cybertom24/6502-computer/README.md

# 6502-computer
My personal repo to build a breadboard version of a computer around the 6502 uProcessor. This project is inspired by the 6502 computer made by Ben Eater (https://eater.net/6502)
