cybertom24/6502-computer/board/out.png

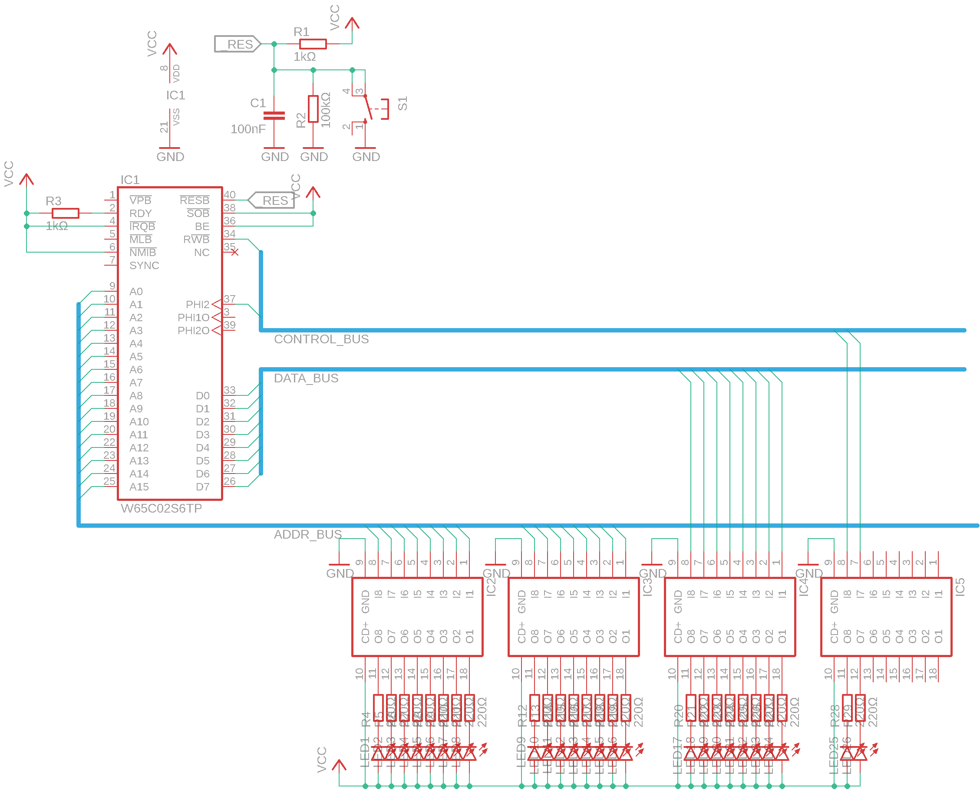
board/out.png
