cybertom24/6502-computer/board/beta-pcb.pdf

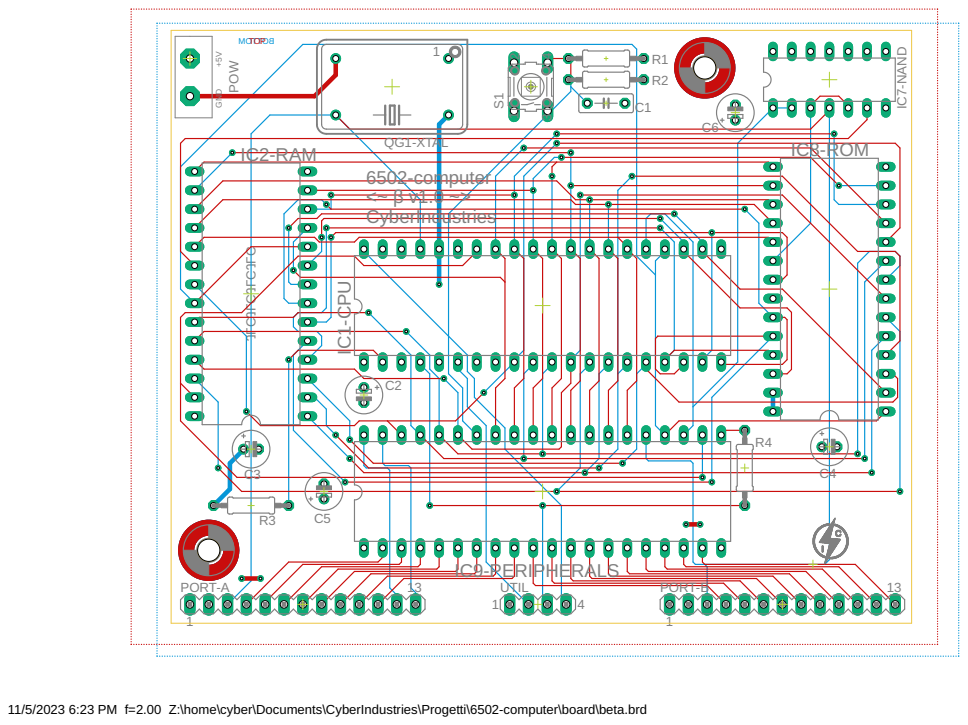
[picture p3: page 1]

11/5/2023 6:23 PM f=2.00 Z:\home\cyber\Documents\CyberIndustries\Progetti\6502-computer\board\beta.brd
