cybertom24/6502-computer/board/beta.pdf

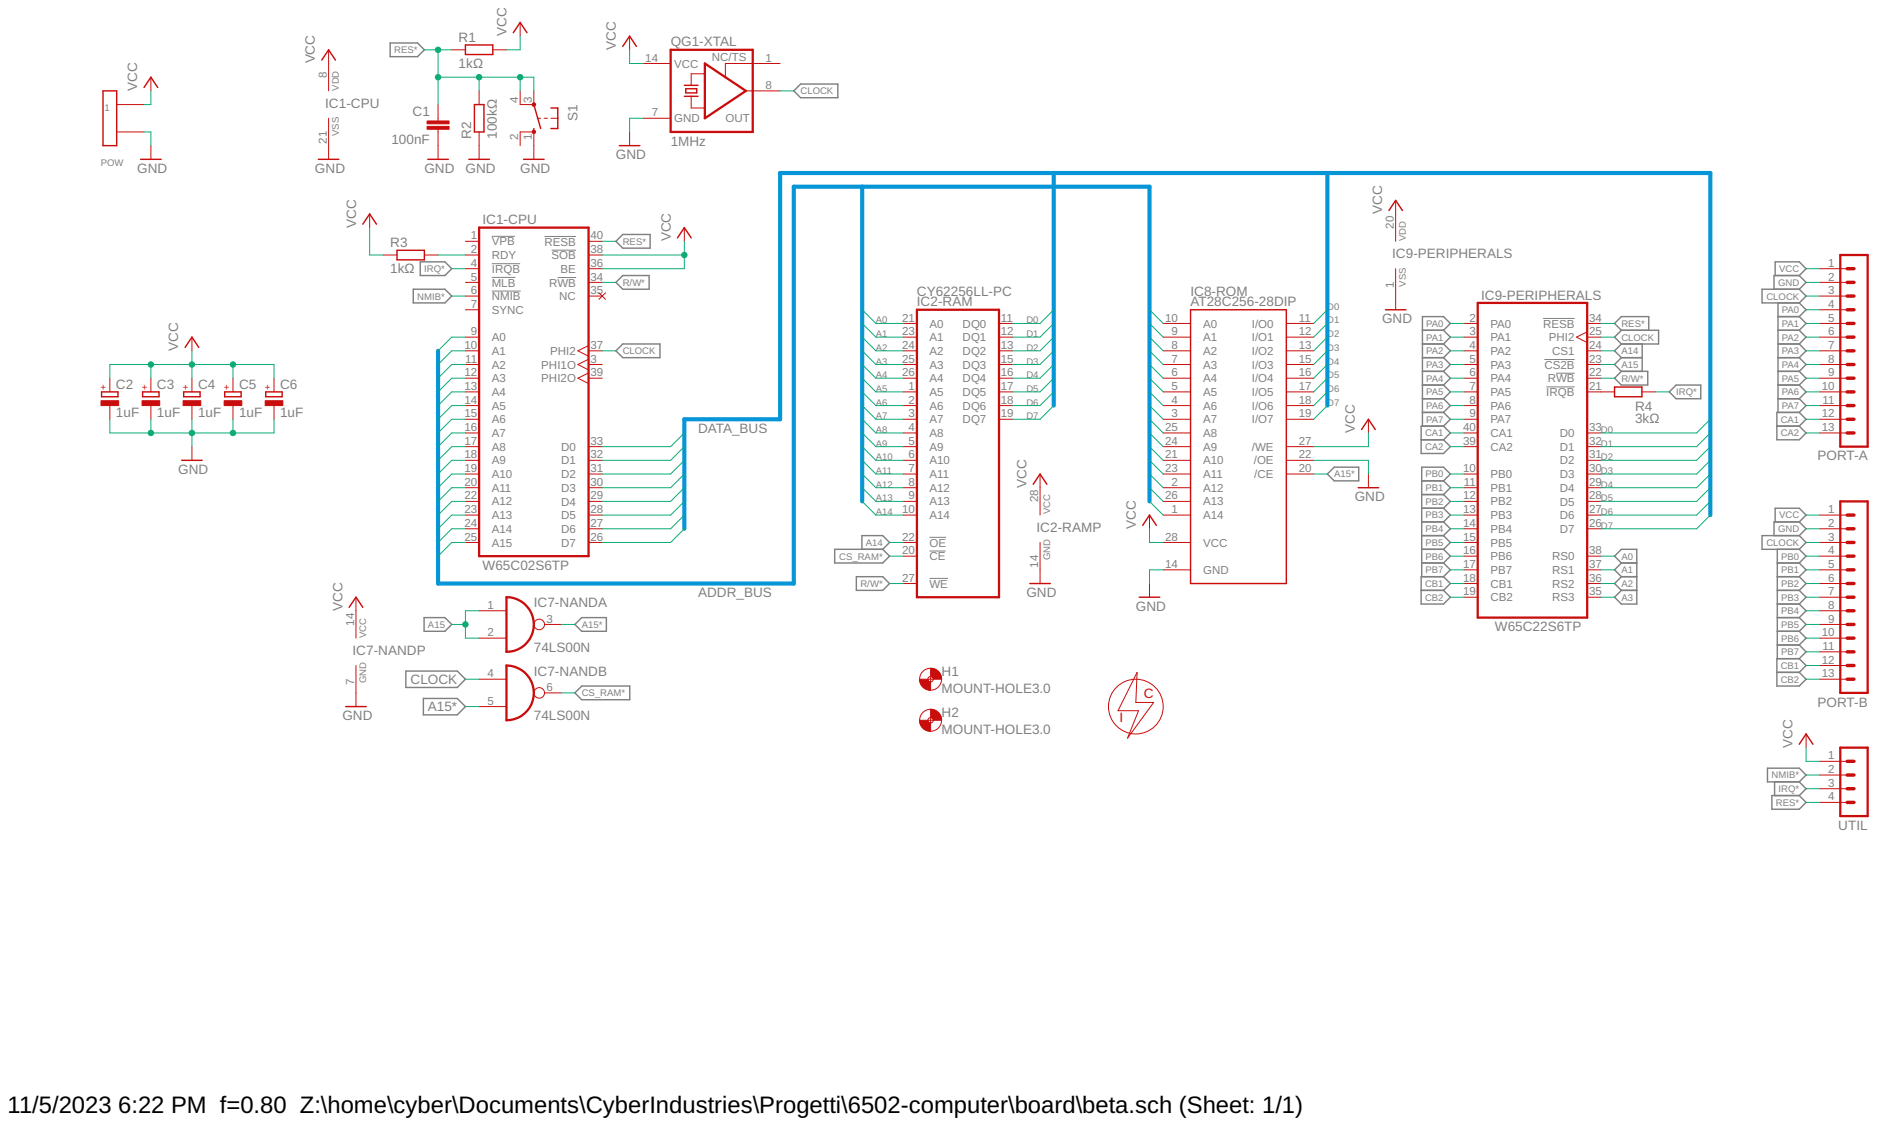
[picture p4: page 1]

11/5/2023 6:22 PM f=0.80 Z:\home\cyber\Documents\CyberIndustries\Progetti\6502-computer\board\beta.sch (Sheet: 1/1)
