cybertom24/6502-computer/board/gamma.brd

## EAGLE design board/gamma.brd (2024-02-10)

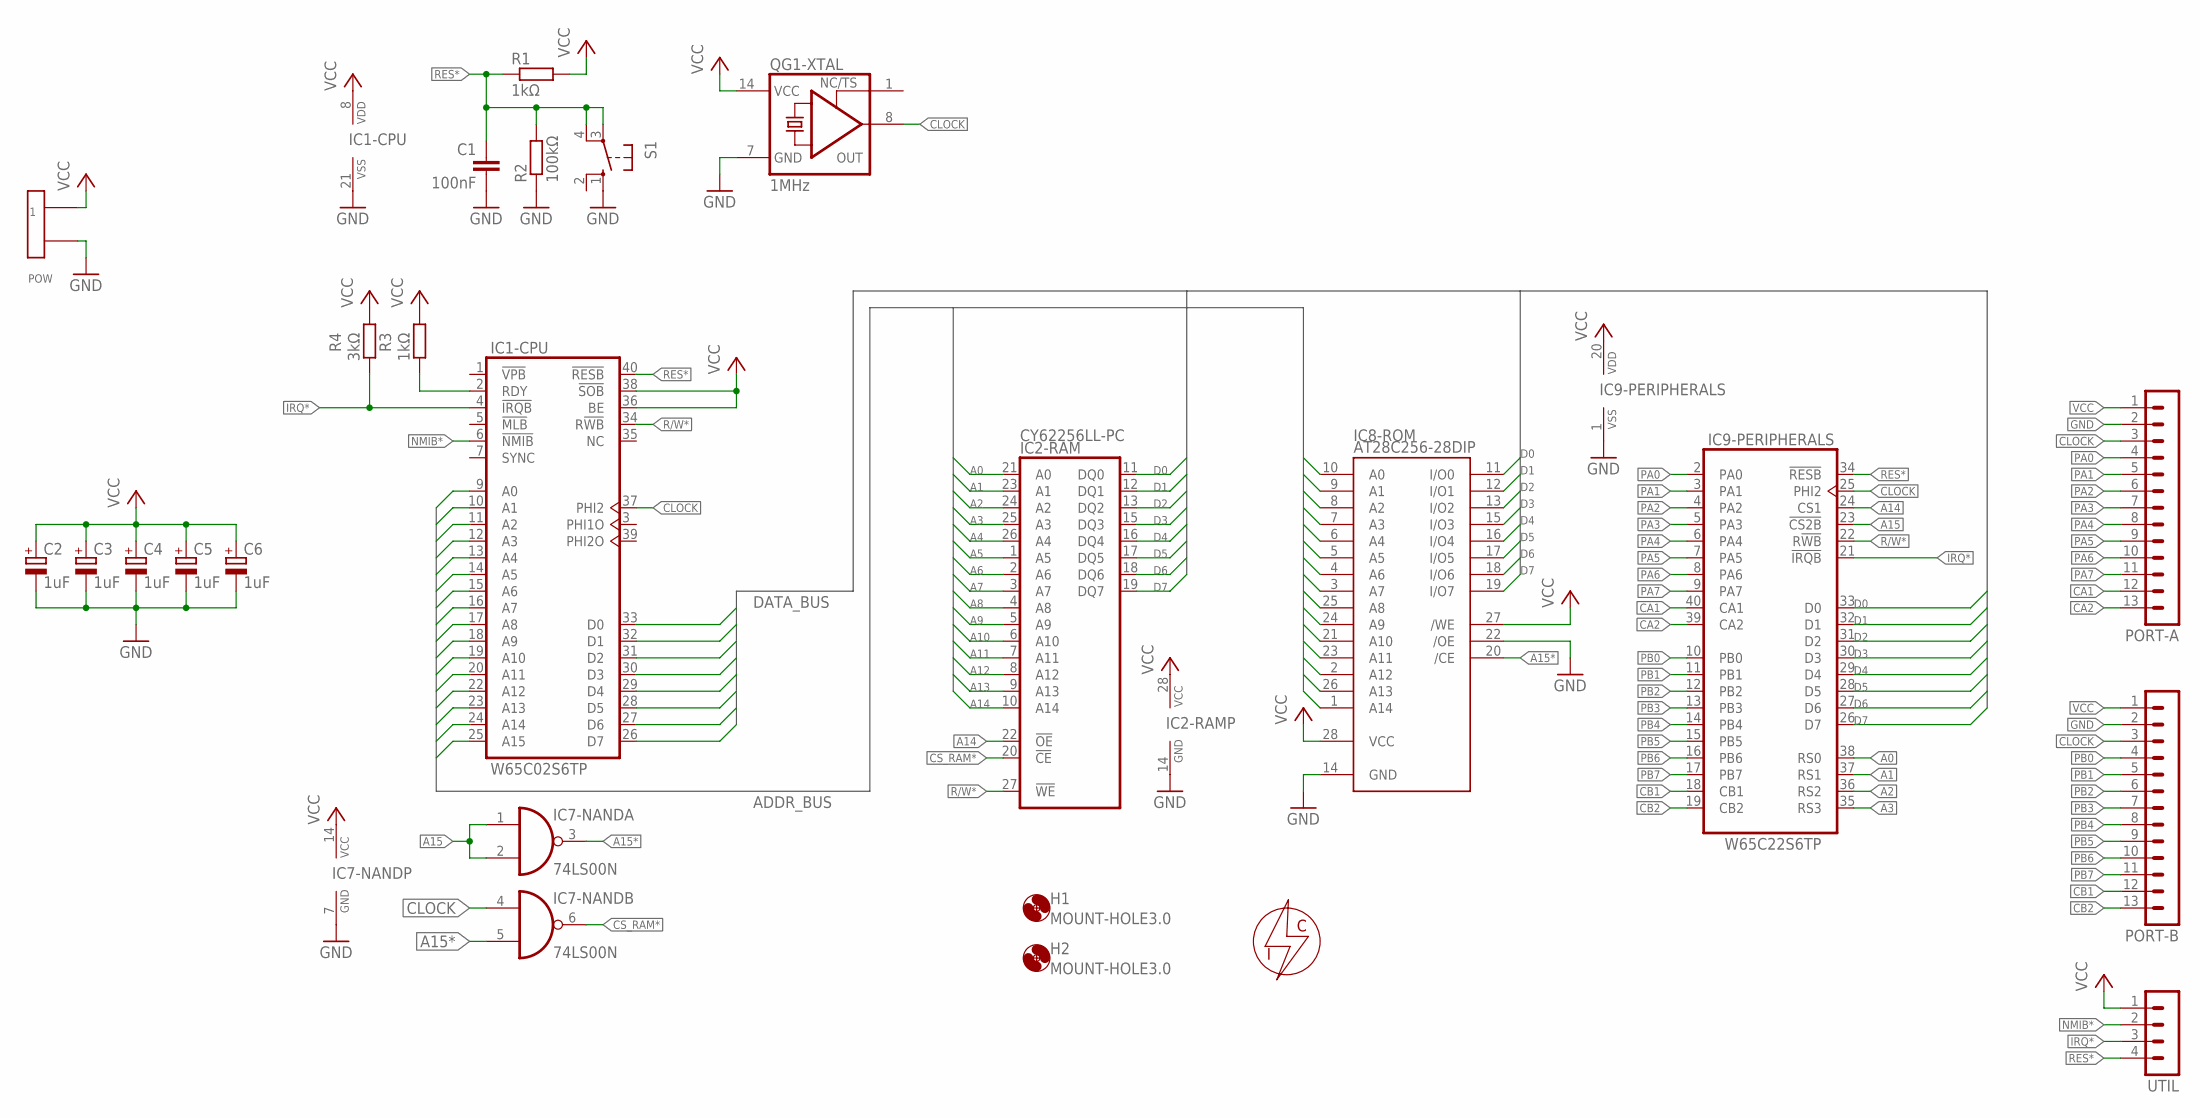
[picture p5: schematic gamma.sch]

Parts:
C1: 100nF; C050-025X075
C2, C3, C4, C5, C6: 1uF; E2-5
H1, H2: MOUNT-HOLE3.0; 3,0
IC1-CPU: W65C02S6TP; DIL40
IC2-RAM: CY62256LL-PC; DIL28-6
IC7-NAND: 74LS00N; DIL14
IC8-ROM: AT28C256-28DIP; DIL28-6
IC9-PERIPHERALS: W65C22S6TP; DIL40
PORT-A: MA13-1
PORT-B: MA13-1
POW: AK500; AK500-2
QG1-XTAL: 1MHz; DIL14S
R1, R3: 1kΩ; 0207/10
R2: 100kΩ; 0207/10
R4: 3kΩ; 0207/10
S1: 10-XX; B3F-10XX
U$1: LOGO-CYBERINDUSTRIES"; LOGO-SMALL
UTIL: MA04-1

Connections:
A0: IC1-CPU.9 (A0), IC2-RAM.21 (A0), IC8-ROM.10 (A0), IC9-PERIPHERALS.38 (RS0)
A1: IC1-CPU.10 (A1), IC2-RAM.23 (A1), IC8-ROM.9 (A1), IC9-PERIPHERALS.37 (RS1)
A2: IC1-CPU.11 (A2), IC2-RAM.24 (A2), IC8-ROM.8 (A2), IC9-PERIPHERALS.36 (RS2)
A3: IC1-CPU.12 (A3), IC2-RAM.25 (A3), IC8-ROM.7 (A3), IC9-PERIPHERALS.35 (RS3)
A4: IC1-CPU.13 (A4), IC2-RAM.26 (A4), IC8-ROM.6 (A4)
A5: IC1-CPU.14 (A5), IC2-RAM.1 (A5), IC8-ROM.5 (A5)
A6: IC1-CPU.15 (A6), IC2-RAM.2 (A6), IC8-ROM.4 (A6)
A7: IC1-CPU.16 (A7), IC2-RAM.3 (A7), IC8-ROM.3 (A7)
A8: IC1-CPU.17 (A8), IC2-RAM.4 (A8), IC8-ROM.25 (A8)
A9: IC1-CPU.18 (A9), IC2-RAM.5 (A9), IC8-ROM.24 (A9)
A10: IC1-CPU.19 (A10), IC2-RAM.6 (A10), IC8-ROM.21 (A10)
A11: IC1-CPU.20 (A11), IC2-RAM.7 (A11), IC8-ROM.23 (A11)
A12: IC1-CPU.22 (A12), IC2-RAM.8 (A12), IC8-ROM.2 (A12)
A13: IC1-CPU.23 (A13), IC2-RAM.9 (A13), IC8-ROM.26 (A13)
A14: IC1-CPU.24 (A14), IC2-RAM.10 (A14), IC2-RAM.22 (!OE), IC8-ROM.1 (A14), IC9-PERIPHERALS.24 (CS1)
A15: IC1-CPU.25 (A15), IC7-NAND.1 (I0), IC7-NAND.2 (I1), IC9-PERIPHERALS.23 (!CS2B)
A15*: IC7-NAND.3 (O), IC7-NAND.5 (I1), IC8-ROM.20 (/CE)
CA1: IC9-PERIPHERALS.40 (CA1), PORT-A.12
CA2: IC9-PERIPHERALS.39 (CA2), PORT-A.13
CB1: IC9-PERIPHERALS.18 (CB1), PORT-B.12
CB2: IC9-PERIPHERALS.19 (CB2), PORT-B.13
CLOCK: IC1-CPU.37 (PHI2), IC7-NAND.4 (I0), IC9-PERIPHERALS.25 (PHI2), PORT-A.3, PORT-B.3, QG1-XTAL.8 (OUT)
CS_RAM*: IC2-RAM.20 (!CE), IC7-NAND.6 (O)
D0: IC1-CPU.33 (D0), IC2-RAM.11 (DQ0), IC8-ROM.11 (I/O0), IC9-PERIPHERALS.33 (D0)
D1: IC1-CPU.32 (D1), IC2-RAM.12 (DQ1), IC8-ROM.12 (I/O1), IC9-PERIPHERALS.32 (D1)
D2: IC1-CPU.31 (D2), IC2-RAM.13 (DQ2), IC8-ROM.13 (I/O2), IC9-PERIPHERALS.31 (D2)
D3: IC1-CPU.30 (D3), IC2-RAM.15 (DQ3), IC8-ROM.15 (I/O3), IC9-PERIPHERALS.30 (D3)
D4: IC1-CPU.29 (D4), IC2-RAM.16 (DQ4), IC8-ROM.16 (I/O4), IC9-PERIPHERALS.29 (D4)
D5: IC1-CPU.28 (D5), IC2-RAM.17 (DQ5), IC8-ROM.17 (I/O5), IC9-PERIPHERALS.28 (D5)
D6: IC1-CPU.27 (D6), IC2-RAM.18 (DQ6), IC8-ROM.18 (I/O6), IC9-PERIPHERALS.27 (D6)
D7: IC1-CPU.26 (D7), IC2-RAM.19 (DQ7), IC8-ROM.19 (I/O7), IC9-PERIPHERALS.26 (D7)
GND: C1.2, C2.-, C3.-, C4.-, C5.-, C6.-, IC1-CPU.21 (VSS), IC2-RAM.14 (GND), IC7-NAND.7 (GND), IC8-ROM.14 (GND), IC8-ROM.22 (/OE), IC9-PERIPHERALS.1 (VSS), PORT-A.2, PORT-B.2, POW.P$2, QG1-XTAL.7 (GND), R2.1, S1.1 (S)
IRQ*: IC1-CPU.4 (!IRQB), IC9-PERIPHERALS.21 (!IRQB), R4.2, UTIL.3
unnamed: IC1-CPU.2 (RDY), R3.2
NMIB*: IC1-CPU.6 (!NMIB), UTIL.2
PA0: IC9-PERIPHERALS.2 (PA0), PORT-A.4
PA1: IC9-PERIPHERALS.3 (PA1), PORT-A.5
PA2: IC9-PERIPHERALS.4 (PA2), PORT-A.6
PA3: IC9-PERIPHERALS.5 (PA3), PORT-A.7
PA4: IC9-PERIPHERALS.6 (PA4), PORT-A.8
PA5: IC9-PERIPHERALS.7 (PA5), PORT-A.9
PA6: IC9-PERIPHERALS.8 (PA6), PORT-A.10
PA7: IC9-PERIPHERALS.9 (PA7), PORT-A.11
PB0: IC9-PERIPHERALS.10 (PB0), PORT-B.4
PB1: IC9-PERIPHERALS.11 (PB1), PORT-B.5
PB2: IC9-PERIPHERALS.12 (PB2), PORT-B.6
PB3: IC9-PERIPHERALS.13 (PB3), PORT-B.7
PB4: IC9-PERIPHERALS.14 (PB4), PORT-B.8
PB5: IC9-PERIPHERALS.15 (PB5), PORT-B.9
PB6: IC9-PERIPHERALS.16 (PB6), PORT-B.10
PB7: IC9-PERIPHERALS.17 (PB7), PORT-B.11
R/W*: IC1-CPU.34 (R!WB), IC2-RAM.27 (!WE), IC9-PERIPHERALS.22 (R!WB)
RES*: C1.1, IC1-CPU.40 (!RESB), IC9-PERIPHERALS.34 (!RESB), R1.1, R2.2, S1.3, S1.4 (P1), UTIL.4
VCC: C2.+, C3.+, C4.+, C5.+, C6.+, IC1-CPU.8 (VDD), IC1-CPU.36 (BE), IC1-CPU.38 (!SOB), IC2-RAM.28 (VCC), IC7-NAND.14 (VCC), IC8-ROM.27 (/WE), IC8-ROM.28 (VCC), IC9-PERIPHERALS.20 (VDD), PORT-A.1, PORT-B.1, POW.P$1, QG1-XTAL.14 (VCC), R1.2, R3.1, R4.1, UTIL.1

Notes on the sheet:
DATA_BUS
ADDR_BUS

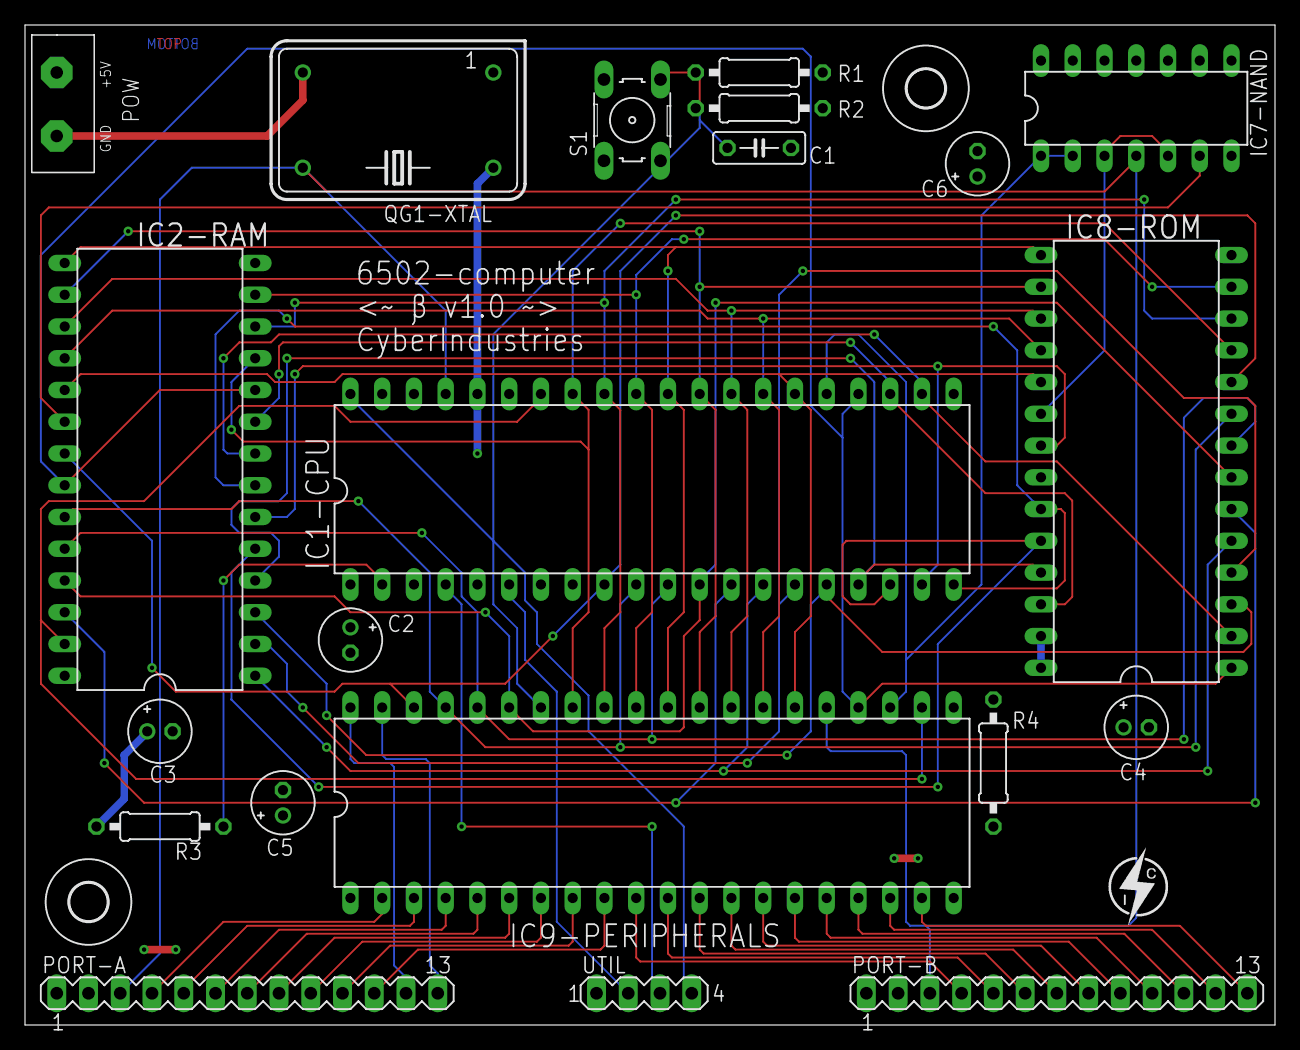
[picture p6: board gamma.brd from above]

Board: 2 copper layers, 100.0 x 80.0 mm, 24 parts (0 on the bottom side), 54 nets.
