cybertom24/6502-computer/(commit log)

2022-07-15 added schematic main board
    [main.sch]
2022-07-15 updated schematic
    [main.sch]
2022-07-20 downloaded emu6502, created ROMImage script, modified board
2022-07-22 modified board
    [main.sch]
2022-07-24 added 555 circuit
    [main.sch]
2022-07-28 created display board
    [display.sch]
2022-07-29 created ROMImage script in python and added LCD display to the schematic
    [main.sch]
2022-08-02 varius things
    [main.sch]
2022-08-23 added lcd
    [main.sch]
2023-03-30 fatto pcb
    [alpha.sch, beta.brd, beta.sch]
2023-03-30 completato pcb
    [beta.brd, beta.sch]
2023-04-05 sistemato pcb
    [beta.brd, beta.sch]
2023-07-19 Modificate schede, creati file ASM
    [beta.brd]
2023-09-11 using vs code instead of 6502.exe, using board with 1 MHz clock
2024-02-10 tanta ma tanta roba
    [gamma.brd, gamma.sch]
2024-03-26 working kbrd reader on arduino
